tanmay2798/Robocon_18/Throwing Mechanism/Electrical control piston./IMG_20170922_024451972.jpg

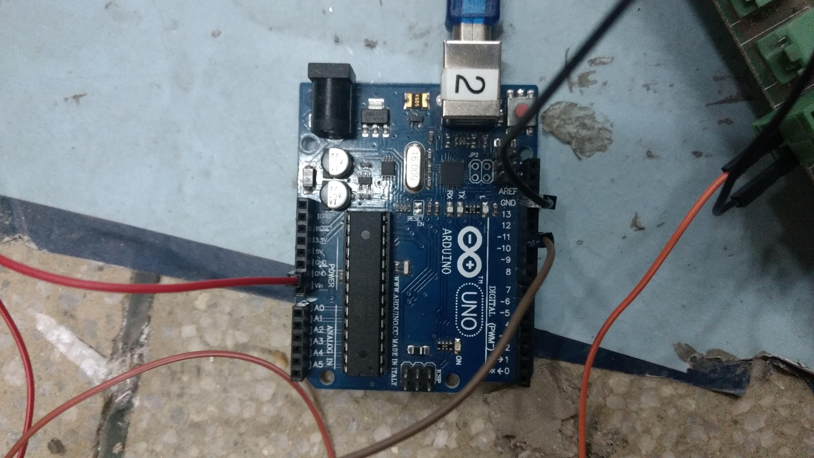
Throwing Mechanism/Electrical control piston./IMG_20170922_024451972.jpg
