tanmay2798/Robocon_18/Manual Drive/Manual Time.xlsx

SNo. | Start to Load | Pick rack | Load to TZ1 | TZ1 to Auto with alignment
1 | 3.31 | 2.16 | 5.5 | 6.1
2 | 4.5 | 1.51 | 6 | 8
3 | 3.59 | 3.67 | 6.06 | 6.89
4
5
6
7
8
9
10
