tanmay2798/Robocon_18/Manual Drive/Manual Drive 2/PS3_Auto_Grip/PS3_Grip_Auto_v8/holonomic_drive_kang/Kangaroo_driver.ino

float target1=0.0,target2=0.0,target3=0.0;
float d1=0.0,d2=0.0,d3=0.0;
float p1=0.0,p2=0.0,p3=0.0;
float s1,s2,s3,vel;
float r1,r2,r3;
void back_Kangaroo_init() {
  K1.start();
  K1.home().wait();
  K1.s(0);
  Serial.println("Started K1");
  K2.start();
  K2.home().wait();
  K2.s(0);
  Serial.println("Started K2");
}

void front_kangaroo_init() {
  M1.start();
  Serial.println("K1 test");
  M1.home().wait();
  M1.s(0);
  Serial.println("Started M1");
}

void drive_kangaroo_update(float motor1, float motor2, float motor3, boolean ramp) {
  if (ramp) {
    K1.s(motor1 * speed_factor, drive_kang_ramp);
    K2.s(motor2 * speed_factor, drive_kang_ramp);
    M1.s(motor3 * speed_factor, drive_kang_ramp);
  } else {
    K1.s(motor1 * speed_factor);
    K2.s(motor2 * speed_factor);
    M1.s(motor3 * speed_factor);
  }
}
