tanmay2798/Robocon_18/Manual Drive/Manual Drive 2/ps_wala/PS3_Grip_v1/holonomic_drive_kang/Gripping.ino

void mos_init(){
  pinMode(mospin1,OUTPUT);
  pinMode(mospin2,OUTPUT);
}
void sol_grip(){
  if (grip==true){
    digitalWrite(mospin1,HIGH);
    digitalWrite(mospin2,HIGH);
  }
  else {
    digitalWrite(mospin1,LOW);
    digitalWrite(mospin2,LOW);
  }
}
