tanmay2798/Robocon_18/Autonomous/sketch_dec06a/sketch_dec06a.ino

const int pingPin = 7;

void setup() {
  // initialize serial communication:
  Serial.begin(9600);
  pinMode(13,OUTPUT);
}

void loop() {

  long duration, inches, cm;
  pinMode(pingPin, OUTPUT);
  digitalWrite(pingPin, LOW);
  delayMicroseconds(2);
  digitalWrite(pingPin, HIGH);
  delayMicroseconds(1000);
  digitalWrite(pingPin, LOW);
  
  pinMode(pingPin, INPUT);
  duration = pulseIn(pingPin, HIGH);
  cm = microsecondsToCentimeters(duration);
  Serial.println(cm);

if(cm<240)
{
  digitalWrite(13,HIGH);
}

else
{
  digitalWrite(13,LOW);
}
  
  delay(100);
}

long microsecondsToCentimeters(long microseconds) {
  return microseconds / 29 / 2;
}
